MakotoKurauchi/1k/pcb/1k.kicad_pcb

## KiCad design pcb/1k.kicad_pcb (2022-05-02)

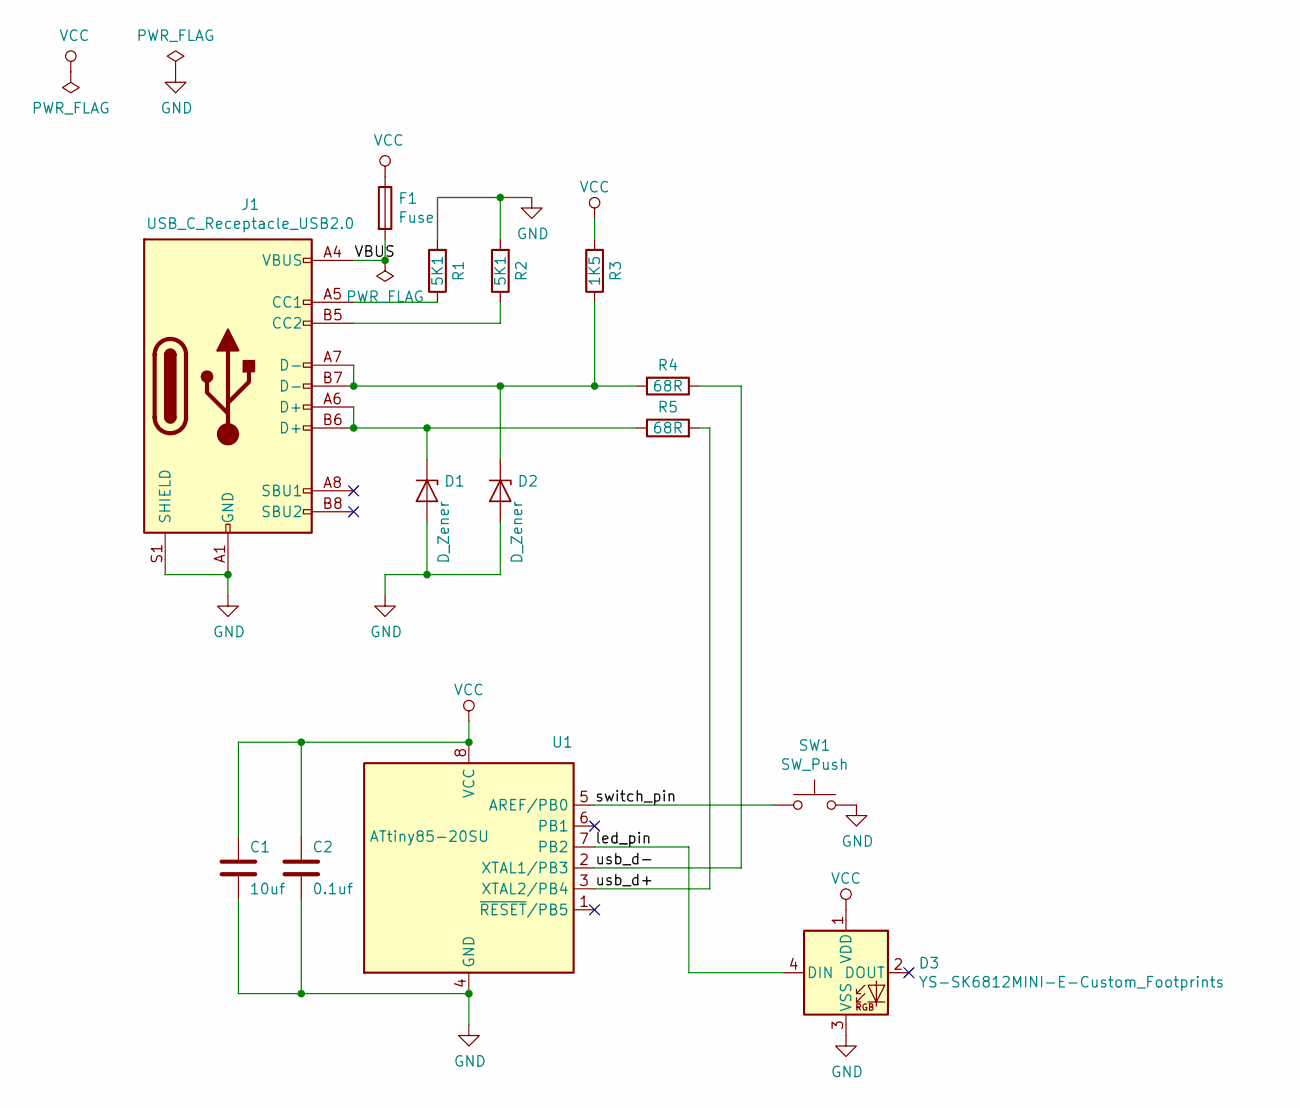
[picture p1: schematic 1k.sch]

Parts:
C1: 10uf; C_0402_1005Metric
C2: 0.1uf; C_0402_1005Metric
D1, D2: D_Zener; D_SOD-323
D3: YS-SK6812MINI-E-Custom_Footprints; YS-SK6812MINI-E_short
F1: Fuse; Fuse_0805_2012Metric
J1: USB_C_Receptacle_USB2.0; USB_C_Receptacle_HRO_TYPE-C-31-M-12
R1, R2: 5K1; R_0402_1005Metric
R3: 1K5; R_0402_1005Metric
R4, R5: 68R; R_0402_1005Metric
SW1: SW_Push; CherryMX_noLed
U1: ATtiny85-20SU; SOIJ-8_5.3x5.3mm_P1.27mm

Connections:
/VBUS: F1.2, J1.A4 (VBUS), J1.A9 (VBUS), J1.B4 (VBUS), J1.B9 (VBUS)
/led_pin: D3.4 (DIN), U1.7 (PB2)
/switch_pin: SW1.1, U1.5 (AREF/PB0)
/usb_d+: R5.2, U1.3 (XTAL2/PB4)
/usb_d-: R4.1, U1.2 (XTAL1/PB3)
GND: C1.2, C2.2, D1.2 (A), D2.2 (A), D3.3 (VSS), J1.A1 (GND), J1.A12 (GND), J1.B1 (GND), J1.B12 (GND), J1.S1 (SHIELD), R1.2, R2.2, SW1.2, U1.4 (GND)
unnamed: D1.1 (K), J1.A6 (D+), J1.B6 (D+), R5.1
unnamed: D2.1 (K), J1.A7 (D-), J1.B7 (D-), R3.1, R4.2
unnamed: J1.A5 (CC1), R1.1
unnamed: J1.B5 (CC2), R2.1
VCC: C1.1, C2.1, D3.1 (VDD), F1.1, R3.2, U1.8 (VCC)

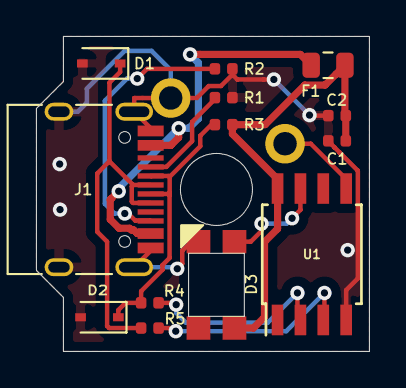
[picture p2: board 1k.kicad_pcb from above]

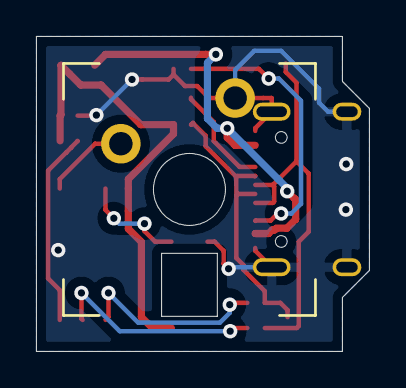
[picture p3: board 1k.kicad_pcb from below]

Board: 2 copper layers, 18.5 x 17.5 mm, 14 parts (2 on the bottom side), 11 nets.
